Vitorbnc/haxmark460/Photos/Boards/DSC_0531.JPG

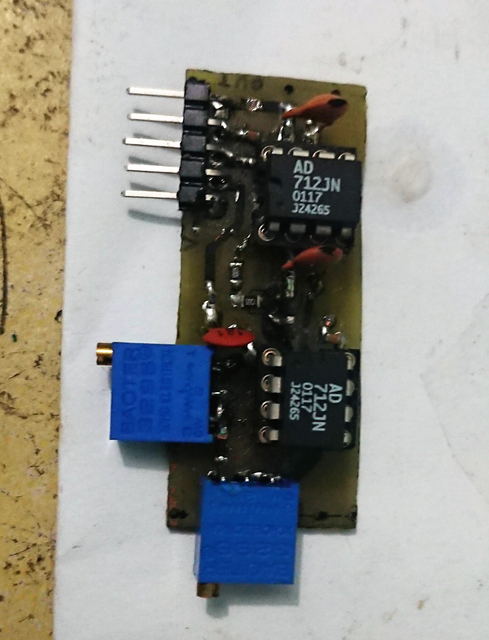
Photos/Boards/DSC_0531.JPG
