Vitorbnc/haxmark460/Photos/Carrier principal frente 4 furos espaçados de  5mm.jpg

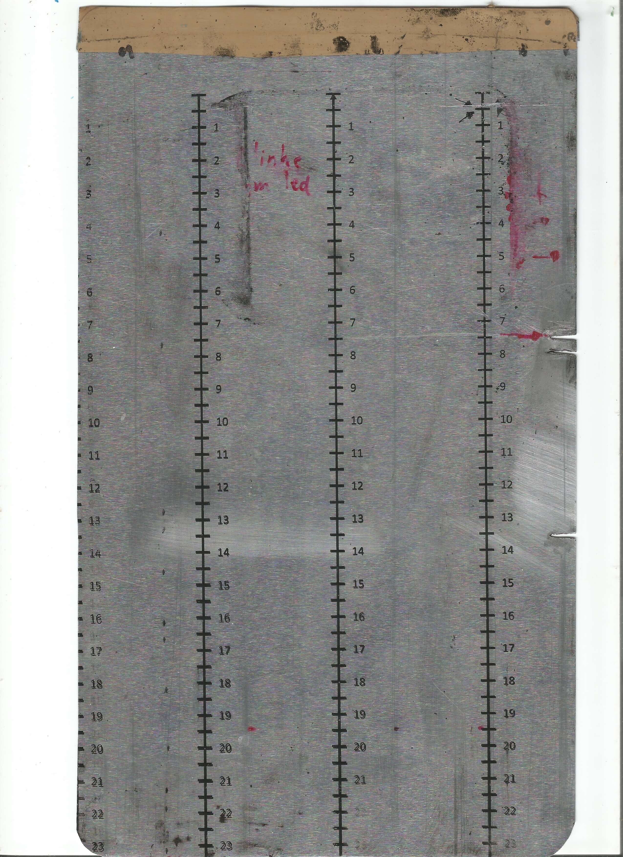
Photos/Carrier principal frente 4 furos espaçados de 5mm.jpg
