Vitorbnc/haxmark460/README.md

# haxmark460
Direct PCB printer based on a Lexmark E460dn

[Detailed build instructions here](https://hackaday.io/project/171775-haxmark460-home-pcb-printer). 

Based on the [haxmark](https://github.com/fruchti/haxmark) project and [this instructable](https://www.instructables.com/Modification-of-the-Lexmark-E260-Laser-Printer-for/).

Quick demo video [here](https://www.youtube.com/watch?v=Cp2N5aJ5IuY).
