Vitorbnc/haxmark460/Alinhamento com furos KiCad - novo.png

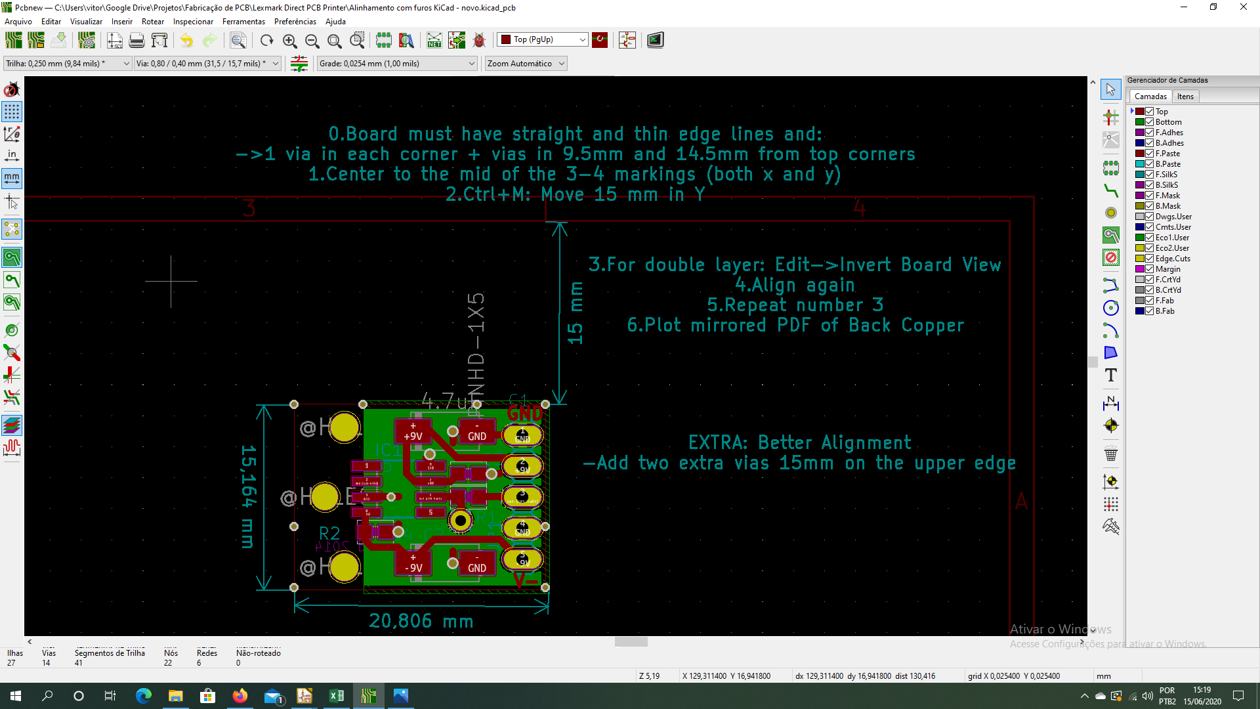
Alinhamento com furos KiCad - novo.png
