Vitorbnc/haxmark460/Alinhamento com régua impressa KiCad.png

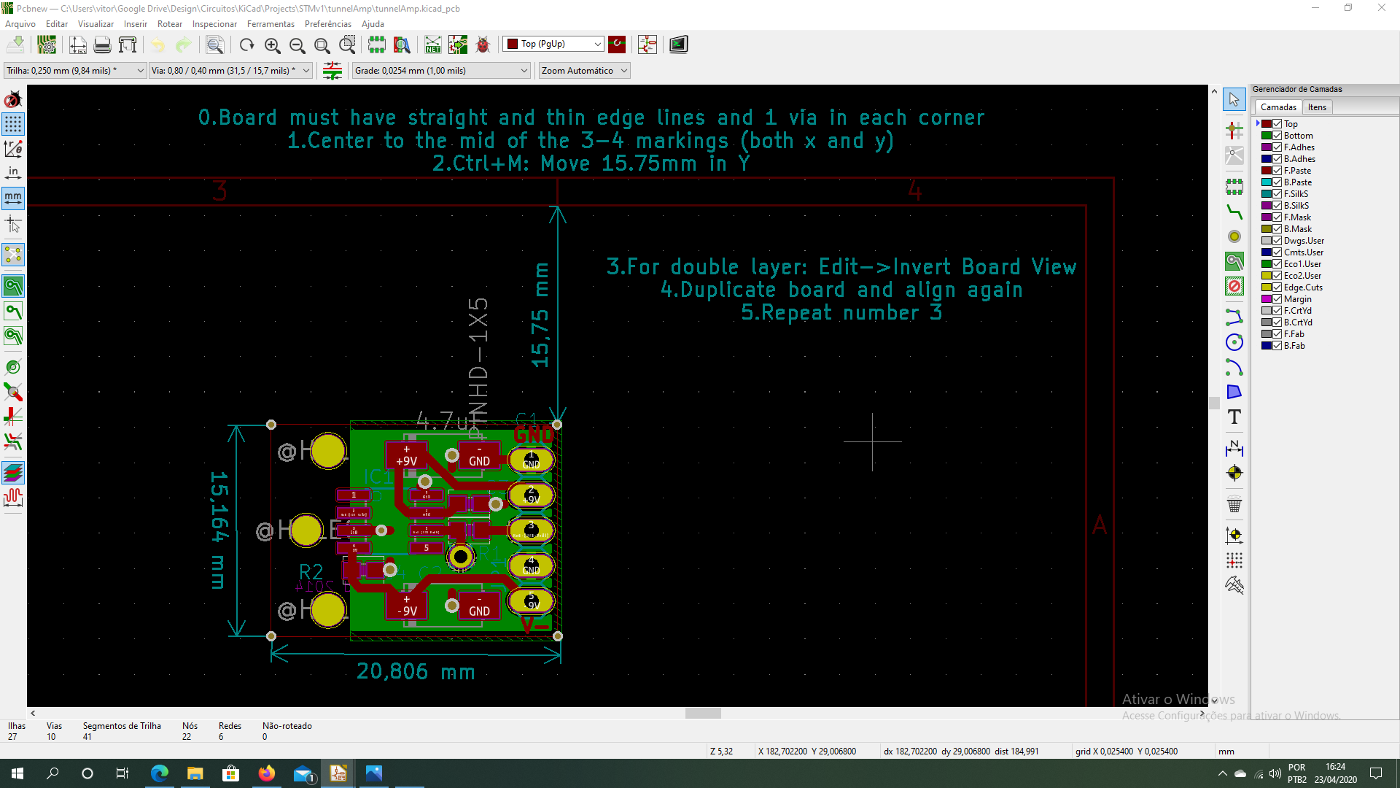
Alinhamento com régua impressa KiCad.png
