Vitorbnc/haxmark460/Outros projetos/lukasku/Sem título 1.png

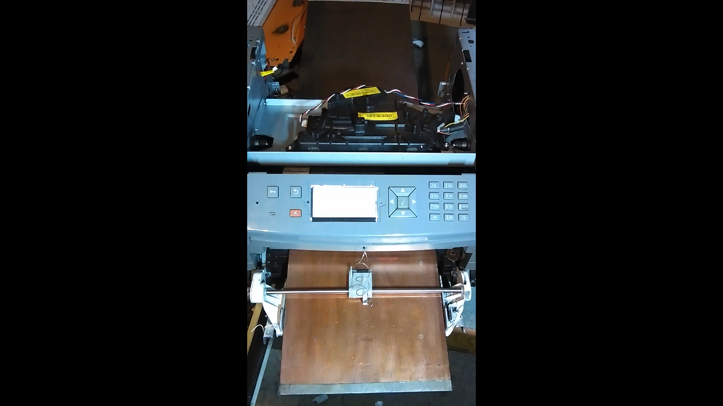
Outros projetos/lukasku/Sem título 1.png
