Vitorbnc/haxmark460/Photos/Boards/DSC_0533.JPG

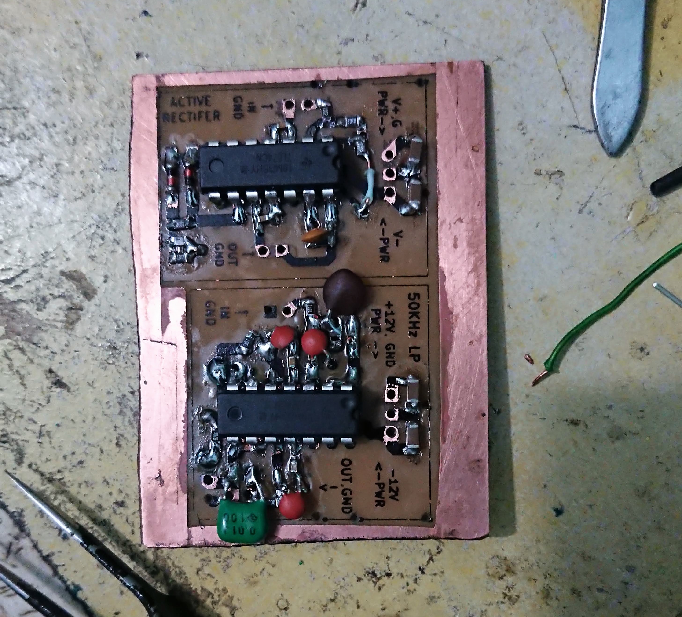
Photos/Boards/DSC_0533.JPG
