Vitorbnc/haxmark460/Photos/Boards/DSC_0535.JPG

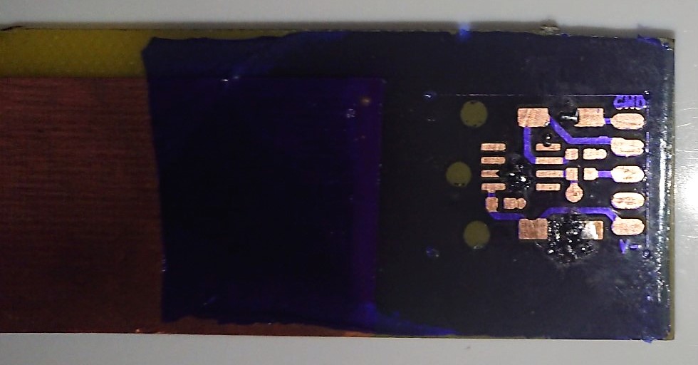
Photos/Boards/DSC_0535.JPG
