Vitorbnc/haxmark460/Photos/Boards/DSC_0544.JPG

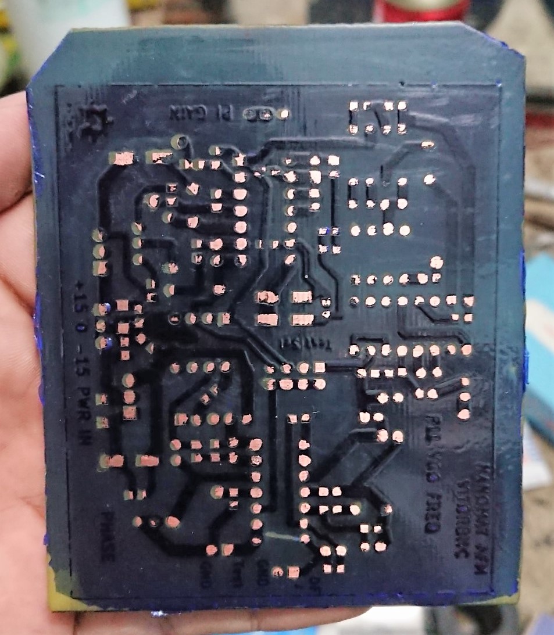
Photos/Boards/DSC_0544.JPG
