Vitorbnc/haxmark460/Photos/Boards/DSC_0614.JPG

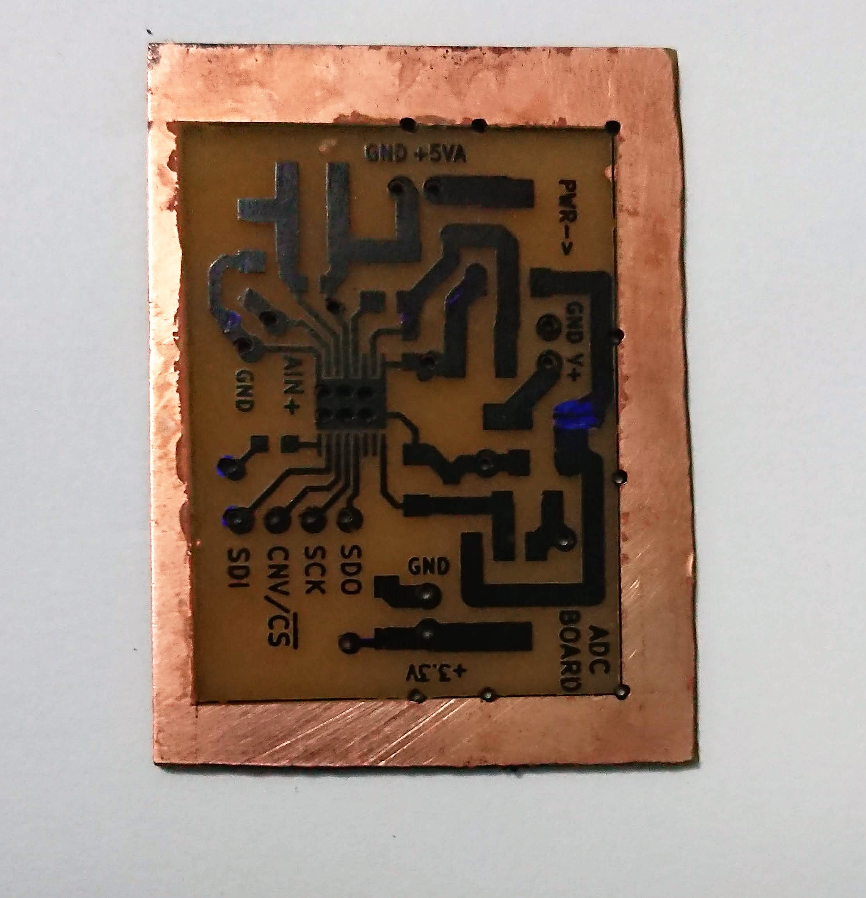
Photos/Boards/DSC_0614.JPG
