Vitorbnc/haxmark460/Photos/Boards/DSC_0616.JPG

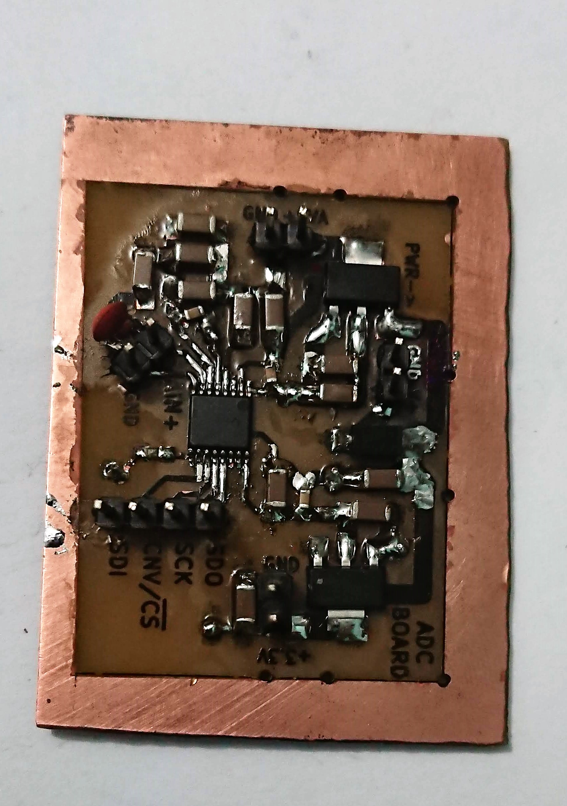
Photos/Boards/DSC_0616.JPG
