Vitorbnc/haxmark460/Photos/Boards/DSC_0641.JPG

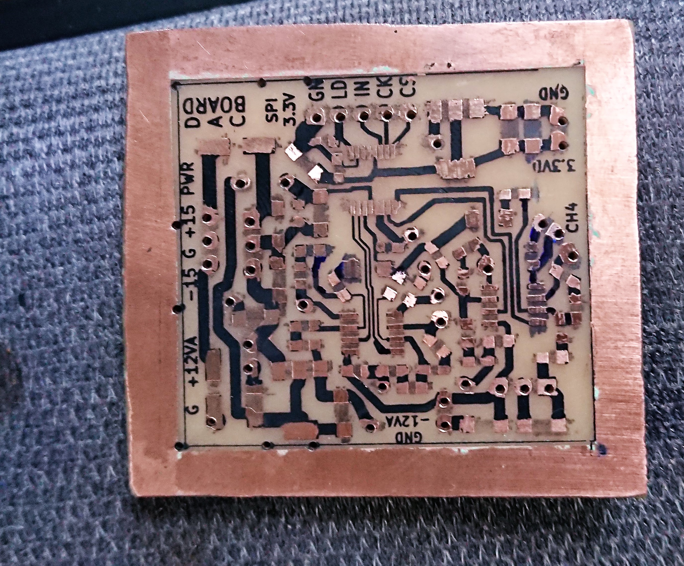
Photos/Boards/DSC_0641.JPG
