Vitorbnc/haxmark460/Photos/Boards/preamp demo.jpg

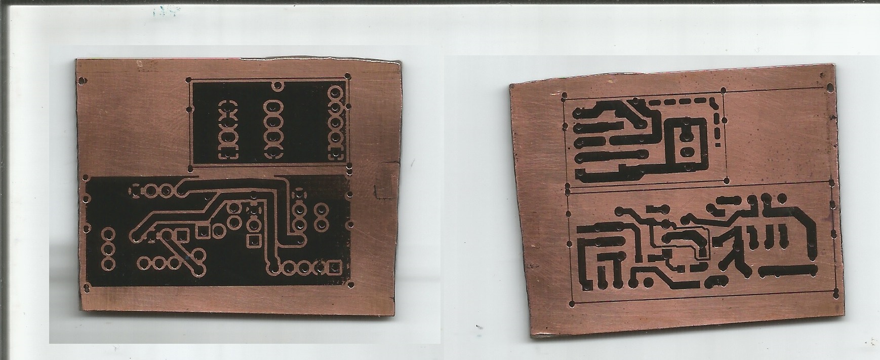
Photos/Boards/preamp demo.jpg
