Vitorbnc/haxmark460/Photos/carrier alternativo.jpg

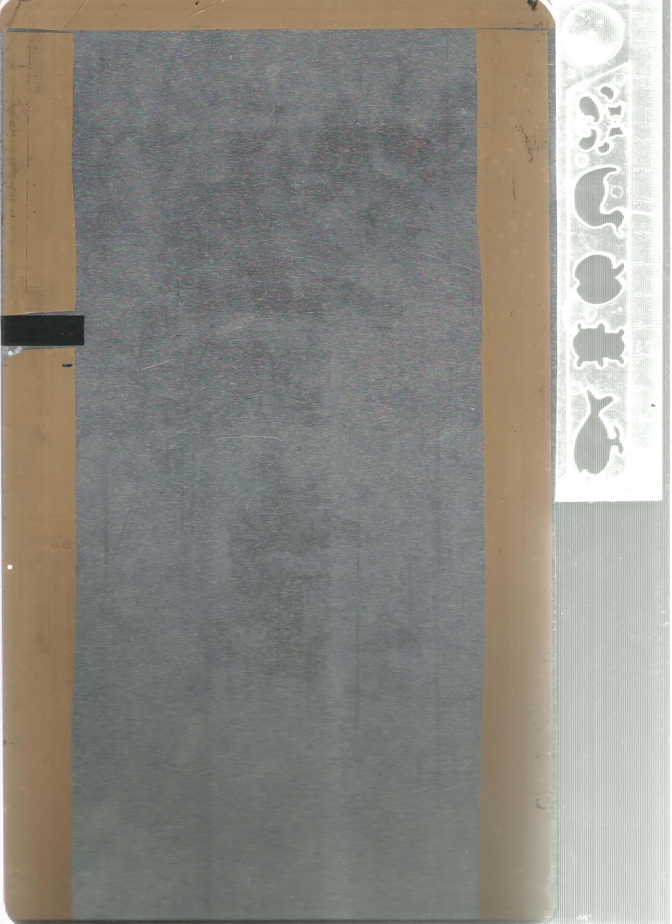
Photos/carrier alternativo.jpg
