Vitorbnc/haxmark460/Photos/Carrier principal verso  4 furos espaçados de  5mm.jpg

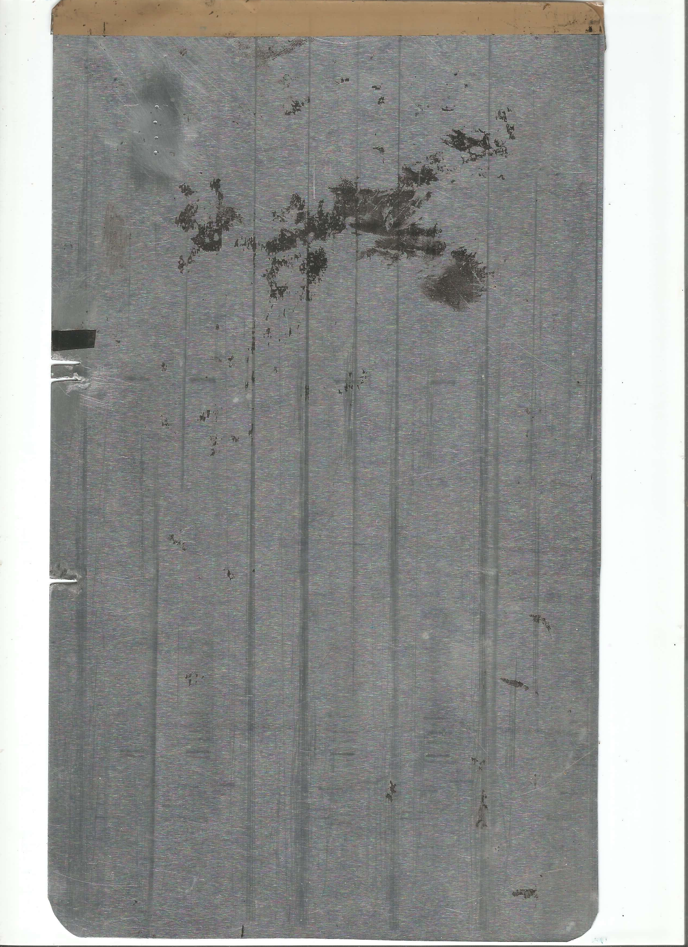
Photos/Carrier principal verso 4 furos espaçados de 5mm.jpg
