Vitorbnc/haxmark460/Photos/DSC_0433.jpg

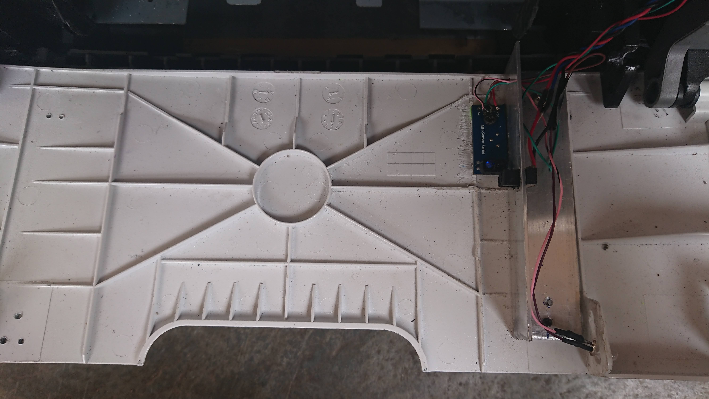
Photos/DSC_0433.jpg
