Vitorbnc/haxmark460/Photos/DSC_0434.jpg

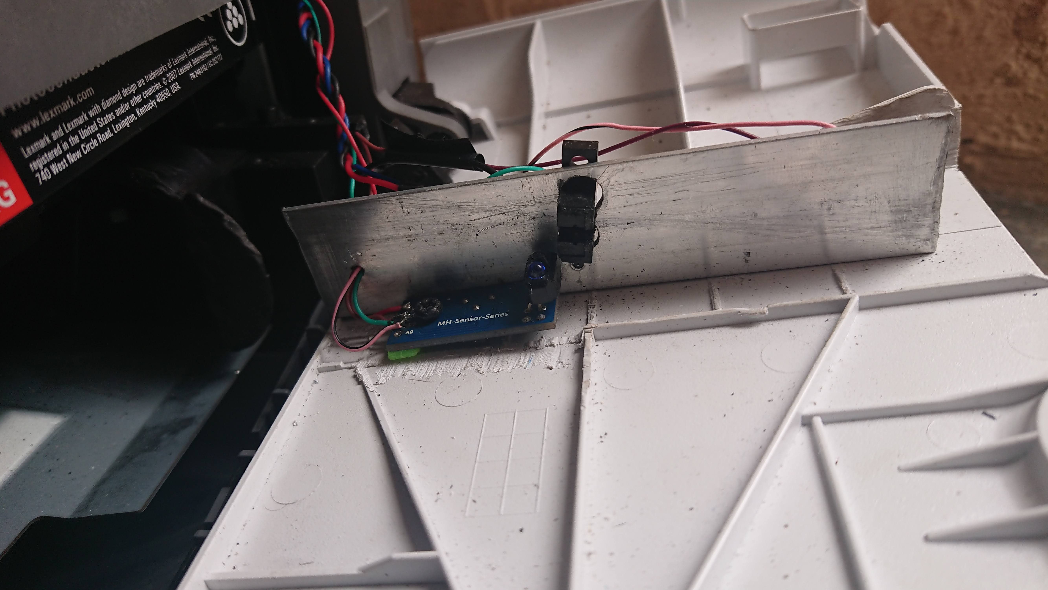
Photos/DSC_0434.jpg
