Vitorbnc/haxmark460/Photos/DSC_0435.jpg

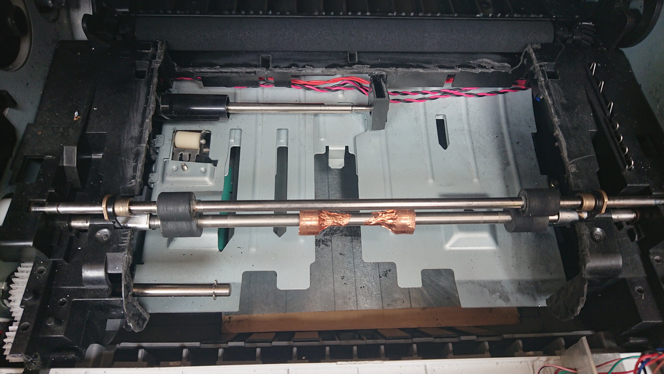
Photos/DSC_0435.jpg
