Vitorbnc/haxmark460/Photos/DSC_0436.jpg

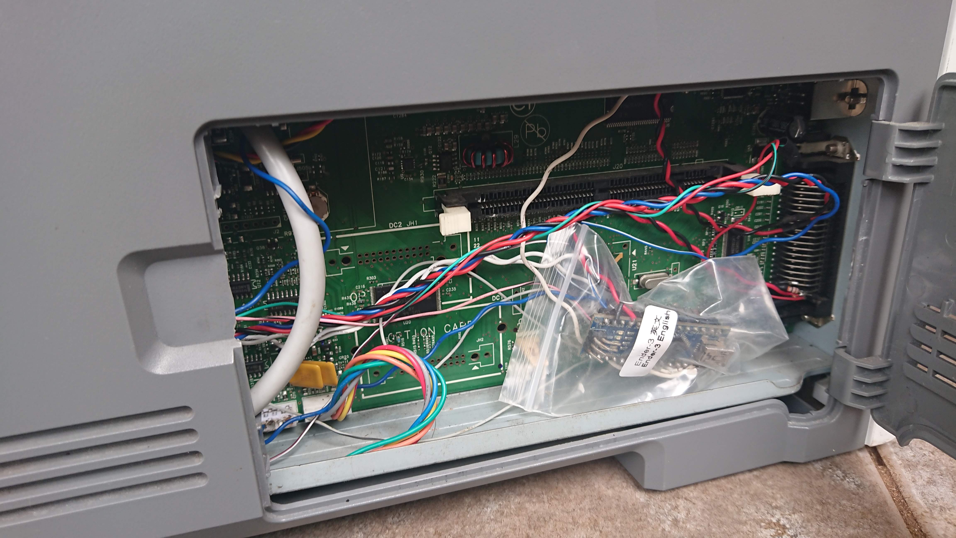
Photos/DSC_0436.jpg
