Vitorbnc/haxmark460/Photos/DSC_0437.jpg

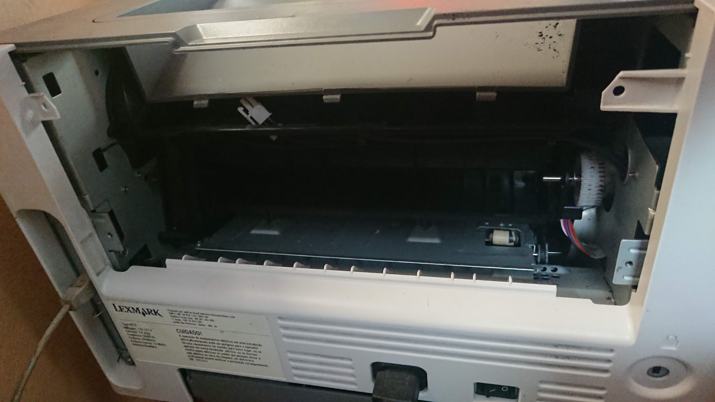
Photos/DSC_0437.jpg
