Vitorbnc/haxmark460/Photos/DSC_0533.JPG

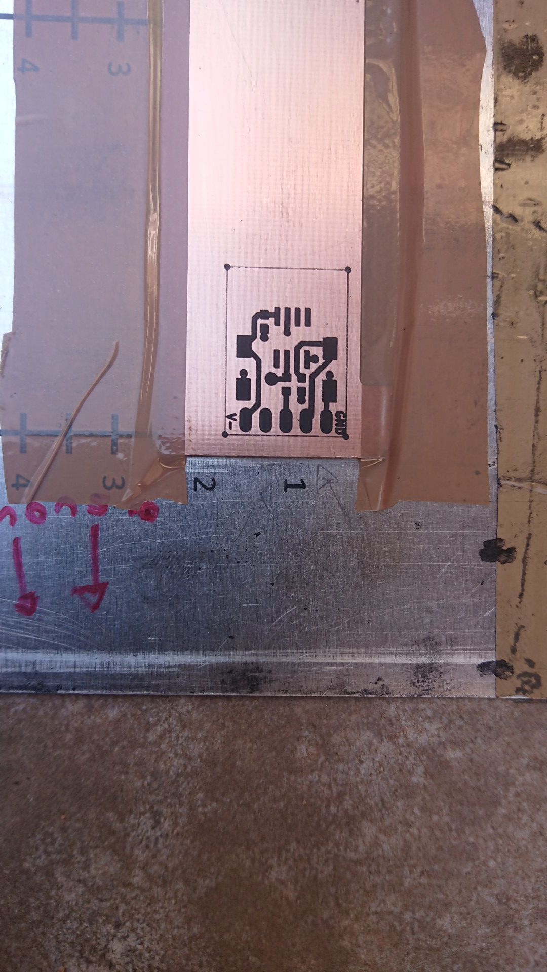
Photos/DSC_0533.JPG
