Vitorbnc/haxmark460/Photos/DSC_0534.JPG

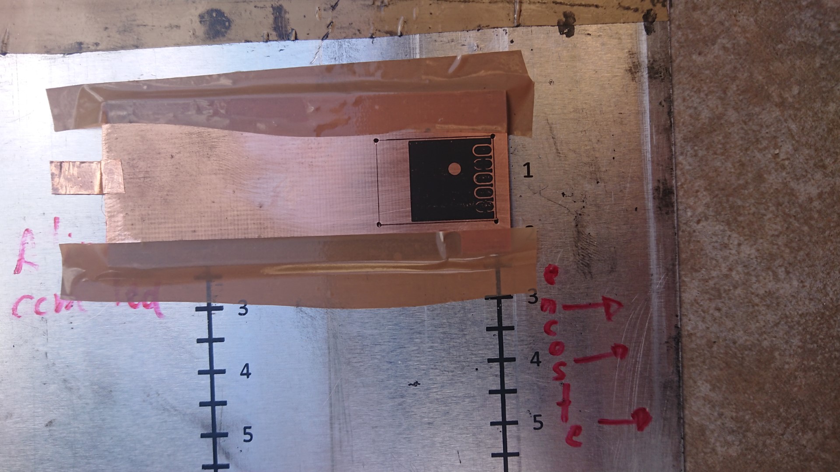
Photos/DSC_0534.JPG
