Vitorbnc/haxmark460/Photos/geral.JPG

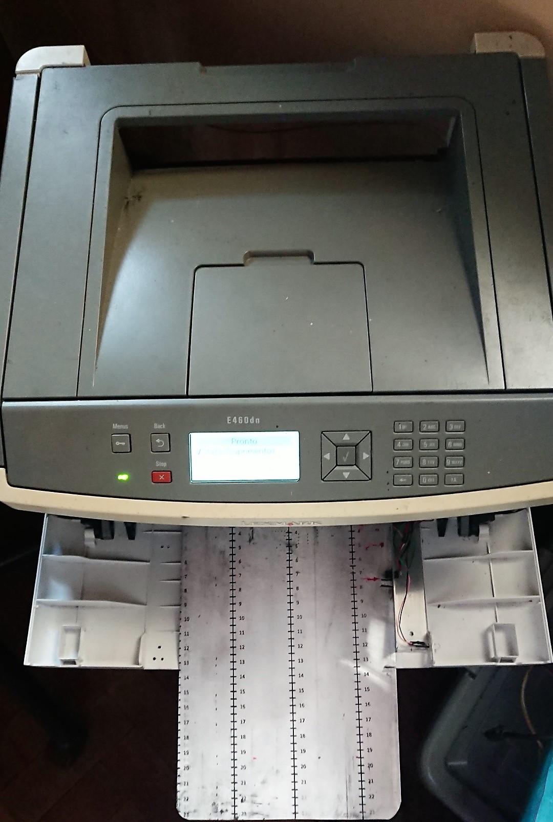
Photos/geral.JPG
