Vitorbnc/haxmark460/Alinhamento com régua impressa KiCad.kicad_pcb

## KiCad design Alinhamento com régua impressa KiCad.kicad_pcb (2020-11-07)

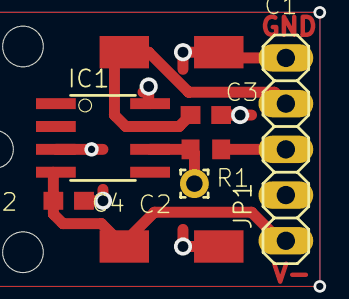
[picture p61: board Alinhamento com régua impressa KiCad.kicad_pcb from above]

Board: 2 copper layers, 11 parts (0 on the bottom side), 5 nets.

Parts:
@HOLE0, @HOLE1, @HOLE2: (no value)
C1, C2: 4.7uF; C_6032-28W
C3, C4: 0.1uF; C0603
IC1: OPA124U; SO08
JP1: PINHD-1X5; 1X05
PAD1: 1,6_0,9
R1: 220; R0603

Connections:
+9V: C1.+, C3.1, IC1.7, JP1.2
-9V: C2.+, C4.1, IC1.4, JP1.5
GND: C1.-, C2.-, C3.2, C4.2, IC1.3, IC1.8, JP1.1, JP1.4
unnamed: IC1.6, PAD1.1, R1.1
unnamed: JP1.3, R1.2
